tuvabjornberg/DC-Fan/media/config.jpg

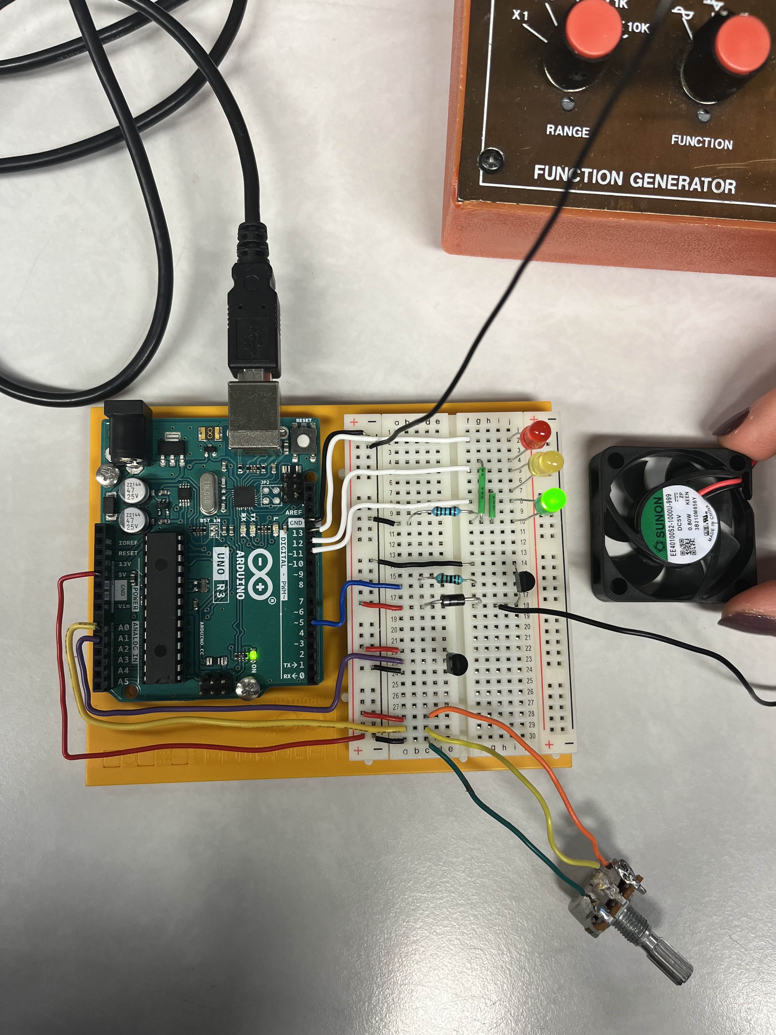
media/config.jpg
