tuvabjornberg/DC-Fan/media/DC-fan_circuit.png

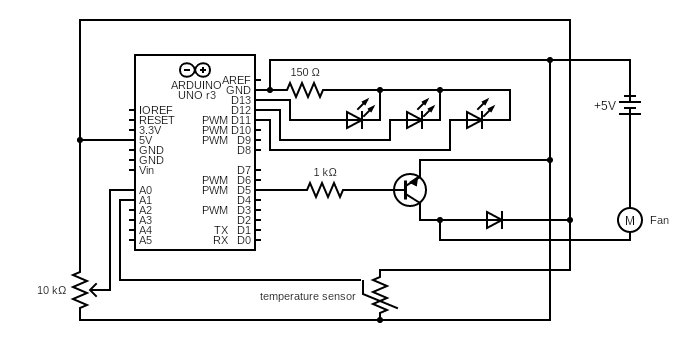
media/DC-fan_circuit.png
