tuvabjornberg/DC-Fan/(commit log)

2024-09-27 blink LED, not tested
2024-10-02 temp setpoints prints in serial monitor
2024-10-02 temp sensor prints
2024-10-02 new pin added
2024-10-08 pin changes
